keyboard-magpie/crkbd/corne-cherry-5col/doc/buildguide_en.md

# Build Guide

This is the Corne Cherry build guide.
The build guide differs depending on the version of your board,
so please choose your own from the following.

- [v2 build guide](https://github.com/foostan/crkbd/blob/master/corne-cherry/doc/v2/buildguide_en.md)
- [v3 build guide](https://github.com/foostan/crkbd/blob/master/corne-cherry/doc/v3/buildguide_en.md)
