keyboard-magpie/crkbd/(commit log)

2023-02-24 add 5col corne cherry variant
    [corne-cherry.kicad_pcb, corne-cherry.kicad_sch, corne-cherry.sch]
2023-02-24 minor fixes to 5col
    [corne-cherry.kicad_pcb]
2023-02-25 corne chocolate v3 5col
    [corne-chocolate.kicad_pcb, corne-chocolate.kicad_sch, corne-chocolate.sch]
2023-02-25 update corne choc v3 5col, add unrouted version for the neater people
    [corne-chocolate-unrouted.kicad_pcb, corne-chocolate.kicad_pcb]
